robgmsn/PureSequencer/Pure Sequencer.brd

## EAGLE design Pure Sequencer.brd (2021-07-07)

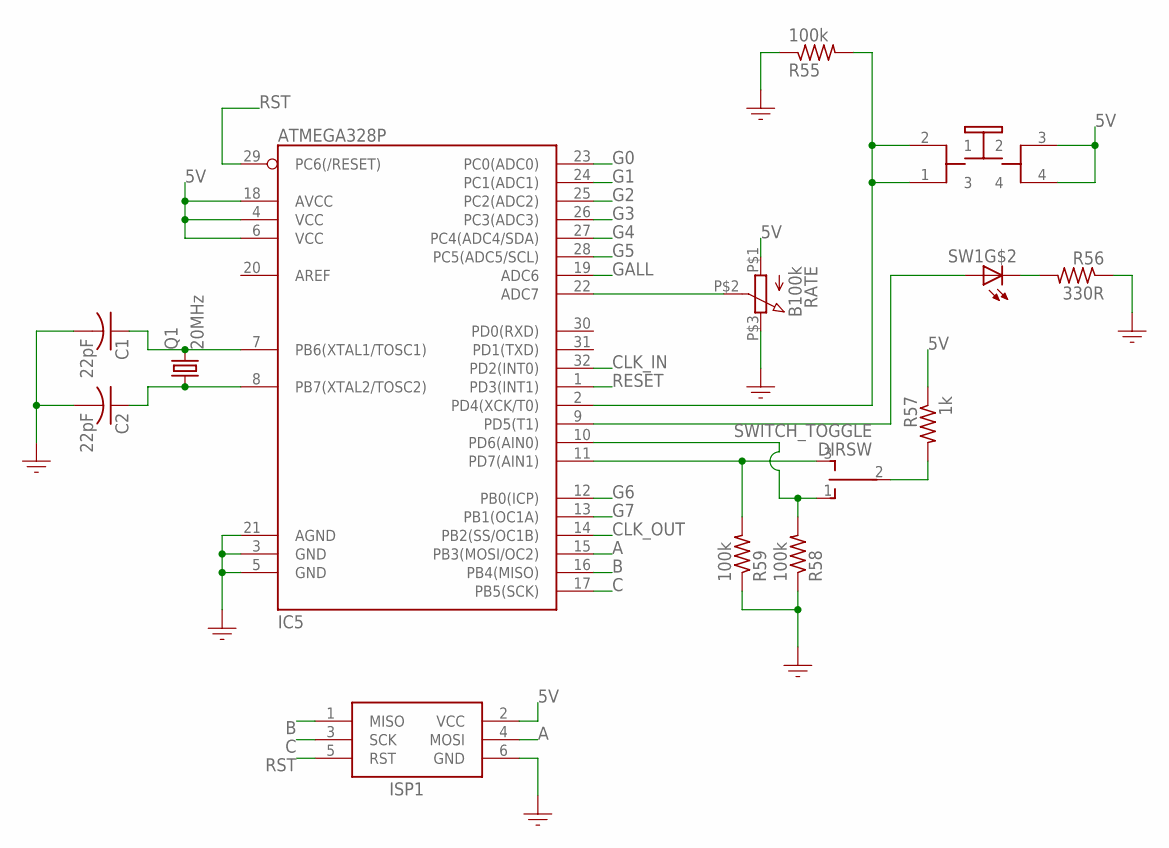
[picture p1: schematic Pure Sequencer.sch, sheet 1]

Parts:
C1, C2: 22pF; C0805
DIRSW: SWITCH_TOGGLE; TOGGLE_SW
IC5: ATMEGA328P; TQFP32-08
ISP1: HEADER2X3-6; AVRISP
Q1: 20MHz; HC49UP
R55, R58, R59: 100k; R0805
R56: 330R; R0805
R57: 1k; R0805
RATE: B100k; POTENTIOMETER_9MM
SW1: SWITCH_PUSHBUTTON_LED; PB6149L

Connections:
5V: IC5.4 (VCC), IC5.6 (VCC), IC5.18 (AVCC), ISP1.2 (VCC), R57.1, RATE.P$1 (1), SW1.3 (2), SW1.4; also elsewhere on the board
A: IC5.15 (PB3(MOSI/OC2)), ISP1.4 (MOSI); also elsewhere on the board
B: IC5.16 (PB4(MISO)), ISP1.1 (MISO); also elsewhere on the board
C: IC5.17 (PB5(SCK)), ISP1.3 (SCK); also elsewhere on the board
CLK_IN: IC5.32 (PD2(INT0)); also elsewhere on the board
CLK_OUT: IC5.14 (PB2(SS/OC1B)); also elsewhere on the board
G0: IC5.23 (PC0(ADC0)); also elsewhere on the board
G1: IC5.24 (PC1(ADC1)); also elsewhere on the board
G2: IC5.25 (PC2(ADC2)); also elsewhere on the board
G3: IC5.26 (PC3(ADC3)); also elsewhere on the board
G4: IC5.27 (PC4(ADC4/SDA)); also elsewhere on the board
G5: IC5.28 (PC5(ADC5/SCL)); also elsewhere on the board
G6: IC5.12 (PB0(ICP)); also elsewhere on the board
G7: IC5.13 (PB1(OC1A)); also elsewhere on the board
GALL: IC5.19 (ADC6)
GND: C1.2, C2.2, IC5.3 (GND), IC5.5 (GND), IC5.21 (AGND), ISP1.6 (GND), R55.1, R56.1, R58.1, R59.1, RATE.P$3 (3); also elsewhere on the board
unnamed: C1.1, IC5.7 (PB6(XTAL1/TOSC1)), Q1.2
unnamed: C2.1, IC5.8 (PB7(XTAL2/TOSC2)), Q1.1
unnamed: IC5.22 (ADC7), RATE.P$2 (2)
unnamed: IC5.2 (PD4(XCK/T0)), R55.2, SW1.1 (3), SW1.2 (1)
unnamed: IC5.9 (PD5(T1)), SW1.A
unnamed: R56.2, SW1.K (C)
unnamed: DIRSW.2, R57.2
unnamed: DIRSW.1 (O), IC5.10 (PD6(AIN0)), R58.2
unnamed: DIRSW.3 (S), IC5.11 (PD7(AIN1)), R59.2
RESET: IC5.1 (PD3(INT1)); also elsewhere on the board
RST: IC5.29 (PC6(/RESET)), ISP1.5 (RST)

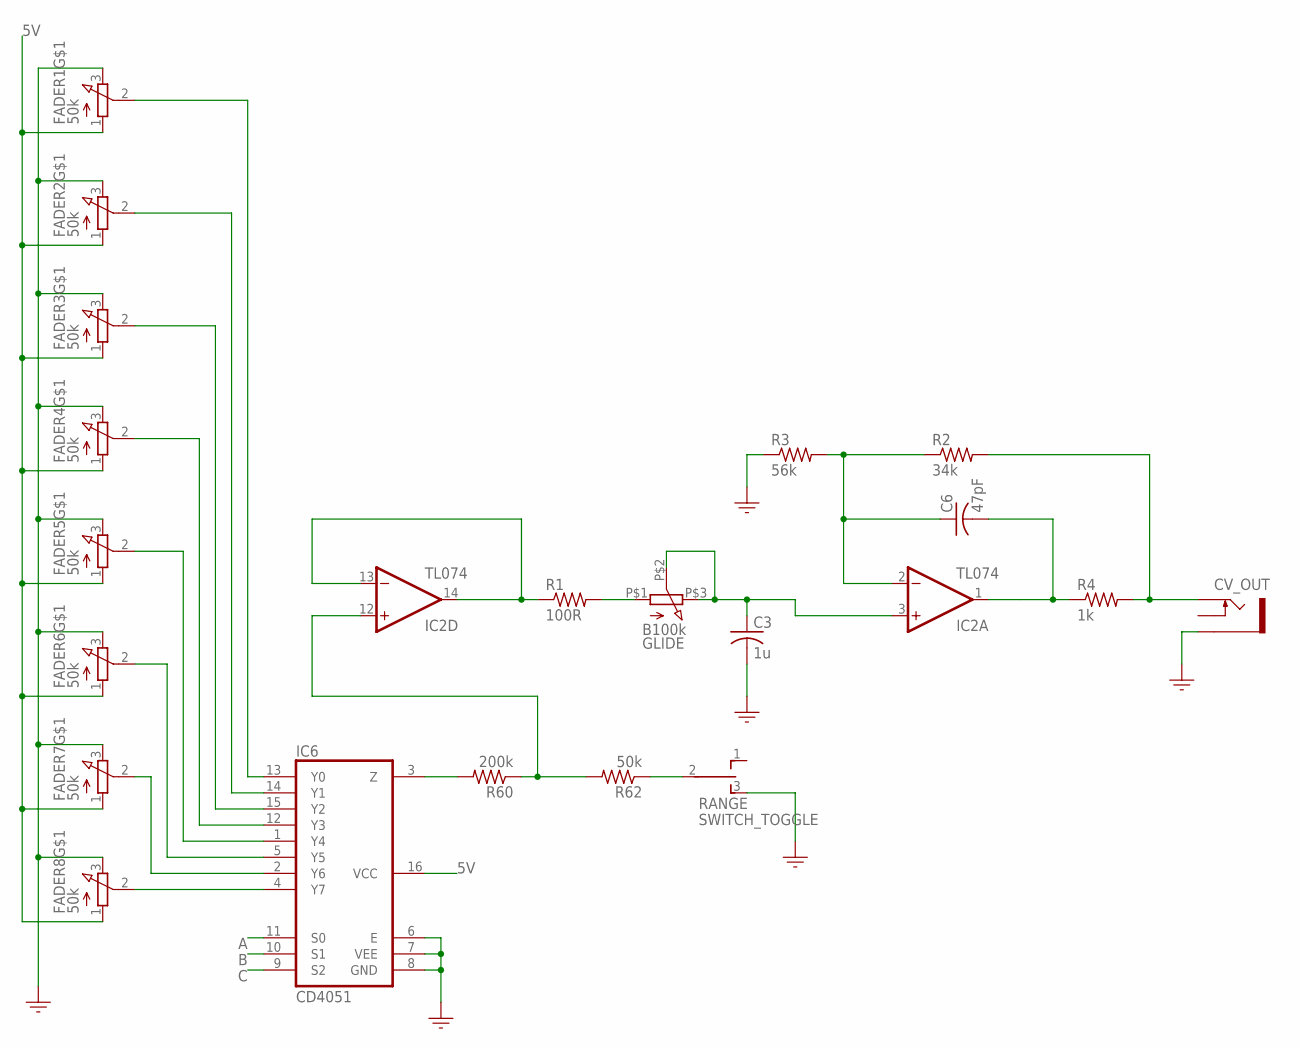
[picture p2: schematic Pure Sequencer.sch, sheet 2]

Parts:
C3: 1u; C0805
C6: 47pF; C0805
CV_OUT: PJ301M-12
FADER1, FADER2, FADER3, FADER4, FADER5, FADER6, FADER7, FADER8: 50k; FADER_20MM_LED
GLIDE: B100k; POTENTIOMETER_9MM
IC2: TL074; SO14
IC6: CD4051; SOIC_16
R1: 100R; R0805
R2: 34k; R0805
R3: 56k; R0805
R4: 1k; R0805
R60: 200k; R0805
R62: 50k; R0805
RANGE: SWITCH_TOGGLE; TOGGLE_SW

Connections:
5V: FADER1.1, FADER2.1, FADER3.1, FADER4.1, FADER5.1, FADER6.1, FADER7.1, FADER8.1, IC6.16 (VCC); also elsewhere on the board
A: IC6.11 (S0); also elsewhere on the board
B: IC6.10 (S1); also elsewhere on the board
C: IC6.9 (S2); also elsewhere on the board
GND: C3.2, CV_OUT.GND (SLEEVE), FADER1.3, FADER2.3, FADER3.3, FADER4.3, FADER5.3, FADER6.3, FADER7.3, FADER8.3, IC6.6 (E), IC6.7 (VEE), IC6.8 (GND), R3.1, RANGE.3 (S); also elsewhere on the board
unnamed: IC2.12 (+IN), R60.1, R62.2
unnamed: IC2.13 (-IN), IC2.14 (OUT), R1.1
unnamed: GLIDE.P$1 (1), R1.2
unnamed: FADER8.2, IC6.4 (Y7)
unnamed: FADER7.2, IC6.2 (Y6)
unnamed: FADER6.2, IC6.5 (Y5)
unnamed: FADER5.2, IC6.1 (Y4)
unnamed: FADER4.2, IC6.12 (Y3)
unnamed: FADER3.2, IC6.15 (Y2)
unnamed: FADER2.2, IC6.14 (Y1)
unnamed: FADER1.2, IC6.13 (Y0)
unnamed: C3.1, GLIDE.P$2 (2), GLIDE.P$3 (3), IC2.3 (+IN)
unnamed: C6.1, IC2.2 (-IN), R2.1, R3.2
unnamed: C6.2, IC2.1 (OUT), R4.1
unnamed: CV_OUT.TIP, R2.2, R4.2
unnamed: IC6.3 (Z), R60.2
unnamed: R62.1, RANGE.2

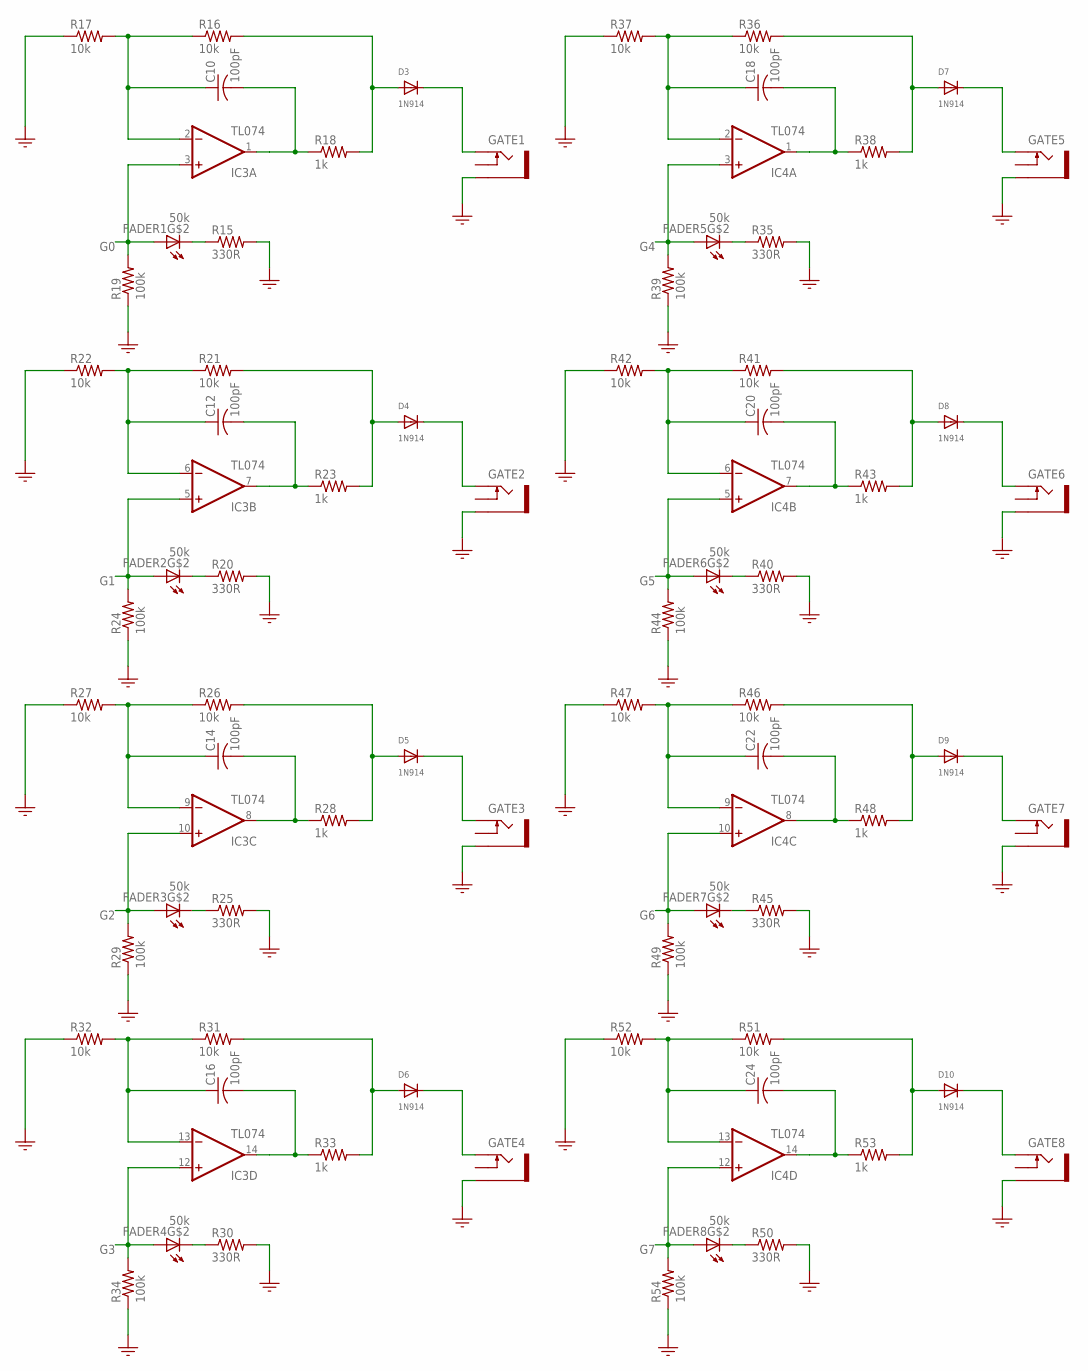
[picture p3: schematic Pure Sequencer.sch, sheet 3]

Parts:
C10, C12, C14, C16, C18, C20, C22, C24: 100pF; C0805
D3, D4, D5, D6, D7, D8, D9, D10: 1N914; DO-41
FADER1, FADER2, FADER3, FADER4, FADER5, FADER6, FADER7, FADER8: 50k; FADER_20MM_LED
GATE1, GATE2, GATE3, GATE4, GATE5, GATE6, GATE7, GATE8: PJ301M-12
IC3, IC4: TL074; SO14
R15, R20, R25, R30, R35, R40, R45, R50: 330R; R0805
R16, R17, R21, R22, R26, R27, R31, R32, R36, R37, R41, R42, R46, R47, R51, R52: 10k; R0805
R18, R23, R28, R33, R38, R43, R48, R53: 1k; R0805
R19, R24, R29, R34, R39, R44, R49, R54: 100k; R0805

Connections:
G0: FADER1.A, IC3.3 (+IN), R19.2; also elsewhere on the board
G1: FADER2.A, IC3.5 (+IN), R24.2; also elsewhere on the board
G2: FADER3.A, IC3.10 (+IN), R29.2; also elsewhere on the board
G3: FADER4.A, IC3.12 (+IN), R34.2; also elsewhere on the board
G4: FADER5.A, IC4.3 (+IN), R39.2; also elsewhere on the board
G5: FADER6.A, IC4.5 (+IN), R44.2; also elsewhere on the board
G6: FADER7.A, IC4.10 (+IN), R49.2; also elsewhere on the board
G7: FADER8.A, IC4.12 (+IN), R54.2; also elsewhere on the board
GND: GATE1.GND (SLEEVE), GATE2.GND (SLEEVE), GATE3.GND (SLEEVE), GATE4.GND (SLEEVE), GATE5.GND (SLEEVE), GATE6.GND (SLEEVE), GATE7.GND (SLEEVE), GATE8.GND (SLEEVE), R15.2, R17.1, R19.1, R20.2, R22.1, R24.1, R25.2, R27.1, R29.1, R30.2, R32.1, R34.1, R35.2, R37.1, R39.1, R40.2, R42.1, R44.1, R45.2, R47.1, R49.1, R50.2, R52.1, R54.1; also elsewhere on the board
unnamed: FADER1.K (C), R15.1
unnamed: C10.1, IC3.2 (-IN), R16.1, R17.2
unnamed: C10.2, IC3.1 (OUT), R18.1
unnamed: D3.A, R16.2, R18.2
unnamed: FADER3.K (C), R25.1
unnamed: FADER2.K (C), R20.1
unnamed: C12.1, IC3.6 (-IN), R21.1, R22.2
unnamed: C12.2, IC3.7 (OUT), R23.1
unnamed: D4.A, R21.2, R23.2
unnamed: C14.1, IC3.9 (-IN), R26.1, R27.2
unnamed: C14.2, IC3.8 (OUT), R28.1
unnamed: D5.A, R26.2, R28.2
unnamed: FADER4.K (C), R30.1
unnamed: C16.1, IC3.13 (-IN), R31.1, R32.2
unnamed: C16.2, IC3.14 (OUT), R33.1
unnamed: D6.A, R31.2, R33.2
unnamed: FADER5.K (C), R35.1
unnamed: C18.1, IC4.2 (-IN), R36.1, R37.2
unnamed: C18.2, IC4.1 (OUT), R38.1
unnamed: D7.A, R36.2, R38.2
unnamed: FADER6.K (C), R40.1
unnamed: C20.1, IC4.6 (-IN), R41.1, R42.2
unnamed: C20.2, IC4.7 (OUT), R43.1
unnamed: D8.A, R41.2, R43.2
unnamed: FADER7.K (C), R45.1
unnamed: C22.1, IC4.9 (-IN), R46.1, R47.2
unnamed: C22.2, IC4.8 (OUT), R48.1
unnamed: D9.A, R46.2, R48.2
unnamed: FADER8.K (C), R50.1
unnamed: C24.1, IC4.13 (-IN), R51.1, R52.2
unnamed: C24.2, IC4.14 (OUT), R53.1
unnamed: D10.A, R51.2, R53.2
unnamed: D6.C, GATE4.TIP
unnamed: D5.C, GATE3.TIP
unnamed: D4.C, GATE2.TIP
unnamed: D3.C, GATE1.TIP
unnamed: D10.C, GATE8.TIP
unnamed: D9.C, GATE7.TIP
unnamed: D8.C, GATE6.TIP
unnamed: D7.C, GATE5.TIP

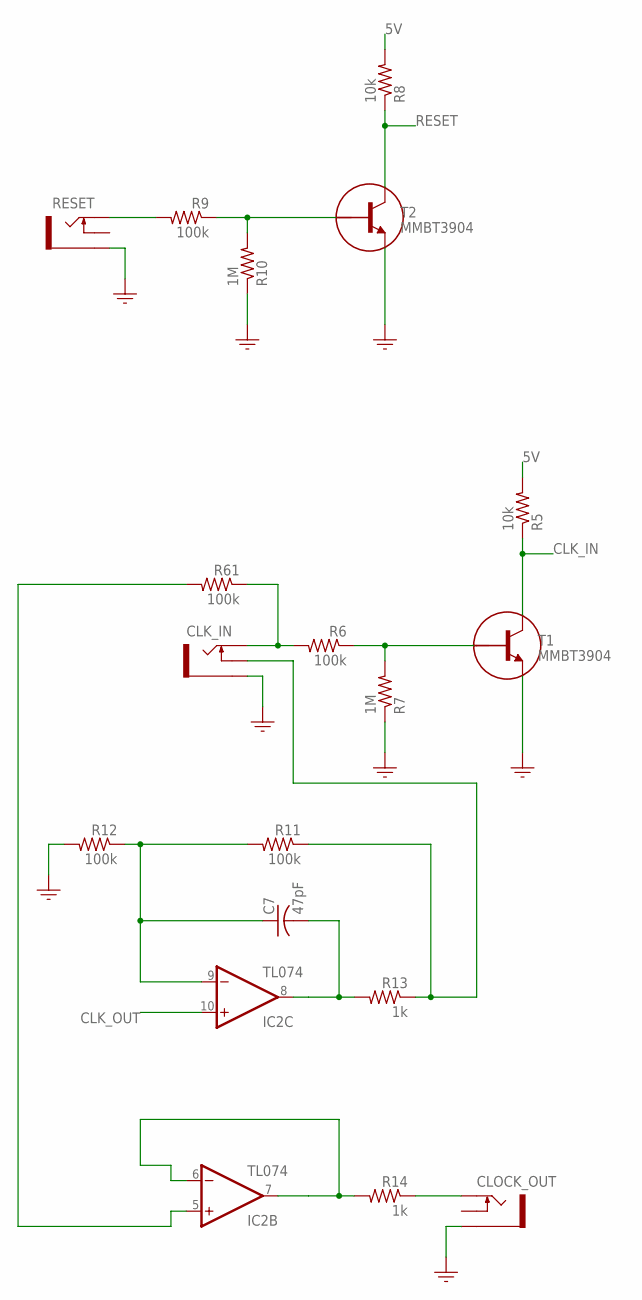
[picture p4: schematic Pure Sequencer.sch, sheet 4]

Parts:
C7: 47pF; C0805
CLK_IN: PJ301M-12
CLOCK_OUT: PJ301M-12
IC2: TL074; SO14
R5, R8: 10k; R0805
R6, R9, R11, R12, R61: 100k; R0805
R7, R10: 1M; R0805
R13, R14: 1k; R0805
RESET: PJ301M-12
T1, T2: MMBT3904; SOT23

Connections:
5V: R5.2, R8.2; also elsewhere on the board
CLK_IN: R5.1, T1.3 (C); also elsewhere on the board
CLK_OUT: IC2.10 (+IN); also elsewhere on the board
GND: CLK_IN.GND (SLEEVE), CLOCK_OUT.GND (SLEEVE), R7.1, R10.1, R12.2, RESET.GND (SLEEVE), T1.2 (E), T2.2 (E); also elsewhere on the board
unnamed: R6.1, R7.2, T1.1 (B)
unnamed: IC2.5 (+IN), R61.2
unnamed: R9.1, R10.2, T2.1 (B)
unnamed: R9.2, RESET.TIP
unnamed: C7.1, IC2.9 (-IN), R11.2, R12.1
unnamed: C7.2, IC2.8 (OUT), R13.2
unnamed: CLK_IN.TIP, R6.2, R61.1
unnamed: IC2.6 (-IN), IC2.7 (OUT), R14.2
unnamed: CLOCK_OUT.TIP, R14.1
unnamed: CLK_IN.NORM (SWITCH), R11.1, R13.1
RESET: R8.1, T2.3 (C); also elsewhere on the board

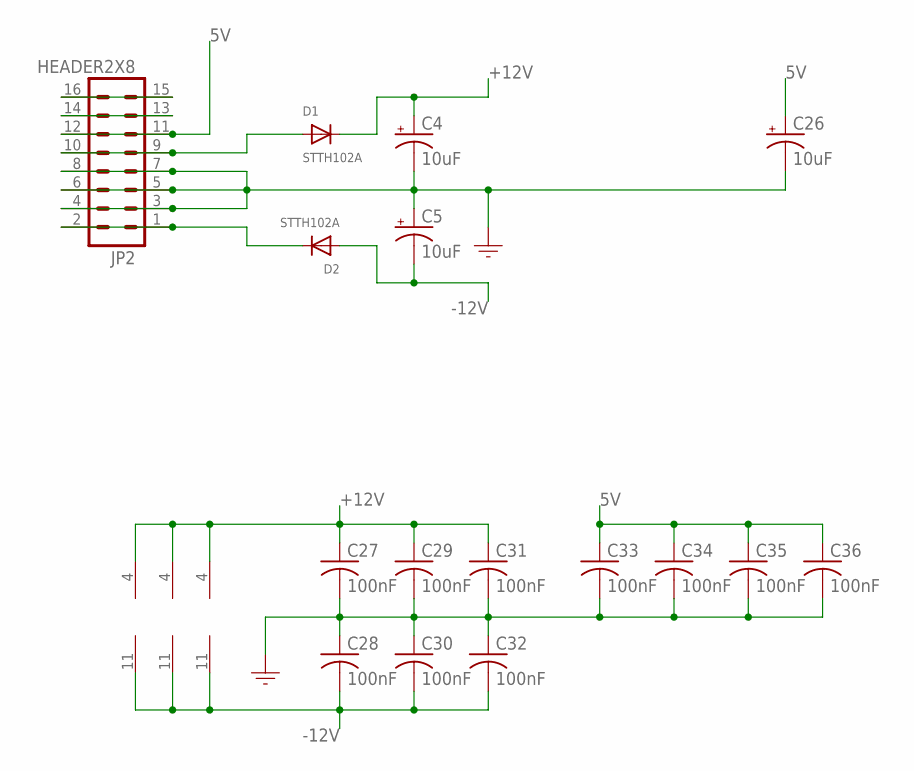
[picture p5: schematic Pure Sequencer.sch, sheet 5]

Parts:
C4, C5, C26: 10uF; 153CLV-0505
C27, C28, C29, C30, C31, C32, C33, C34, C35, C36: 100nF; C0805
D1, D2: STTH102A; SMADIODE
IC2, IC3, IC4: TL074; SO14
JP2: HEADER2X8; POWER_SHROUDED

Connections:
5V: C26.+, C33.1, C34.1, C35.1, C36.1, JP2.11, JP2.12; also elsewhere on the board
+12V: C4.+, C27.1, C29.1, C31.1, D1.C, IC2.4 (V+), IC3.4 (V+), IC4.4 (V+)
-12V: C5.-, C28.2, C30.2, C32.2, D2.A, IC2.11 (V-), IC3.11 (V-), IC4.11 (V-)
GND: C4.-, C5.+, C26.-, C27.2, C28.1, C29.2, C30.1, C31.2, C32.1, C33.2, C34.2, C35.2, C36.2, JP2.3, JP2.4, JP2.5, JP2.6, JP2.7, JP2.8; also elsewhere on the board
unnamed: D1.A, JP2.9, JP2.10
unnamed: D2.C, JP2.1, JP2.2
unnamed: JP2.13, JP2.14
unnamed: JP2.15, JP2.16

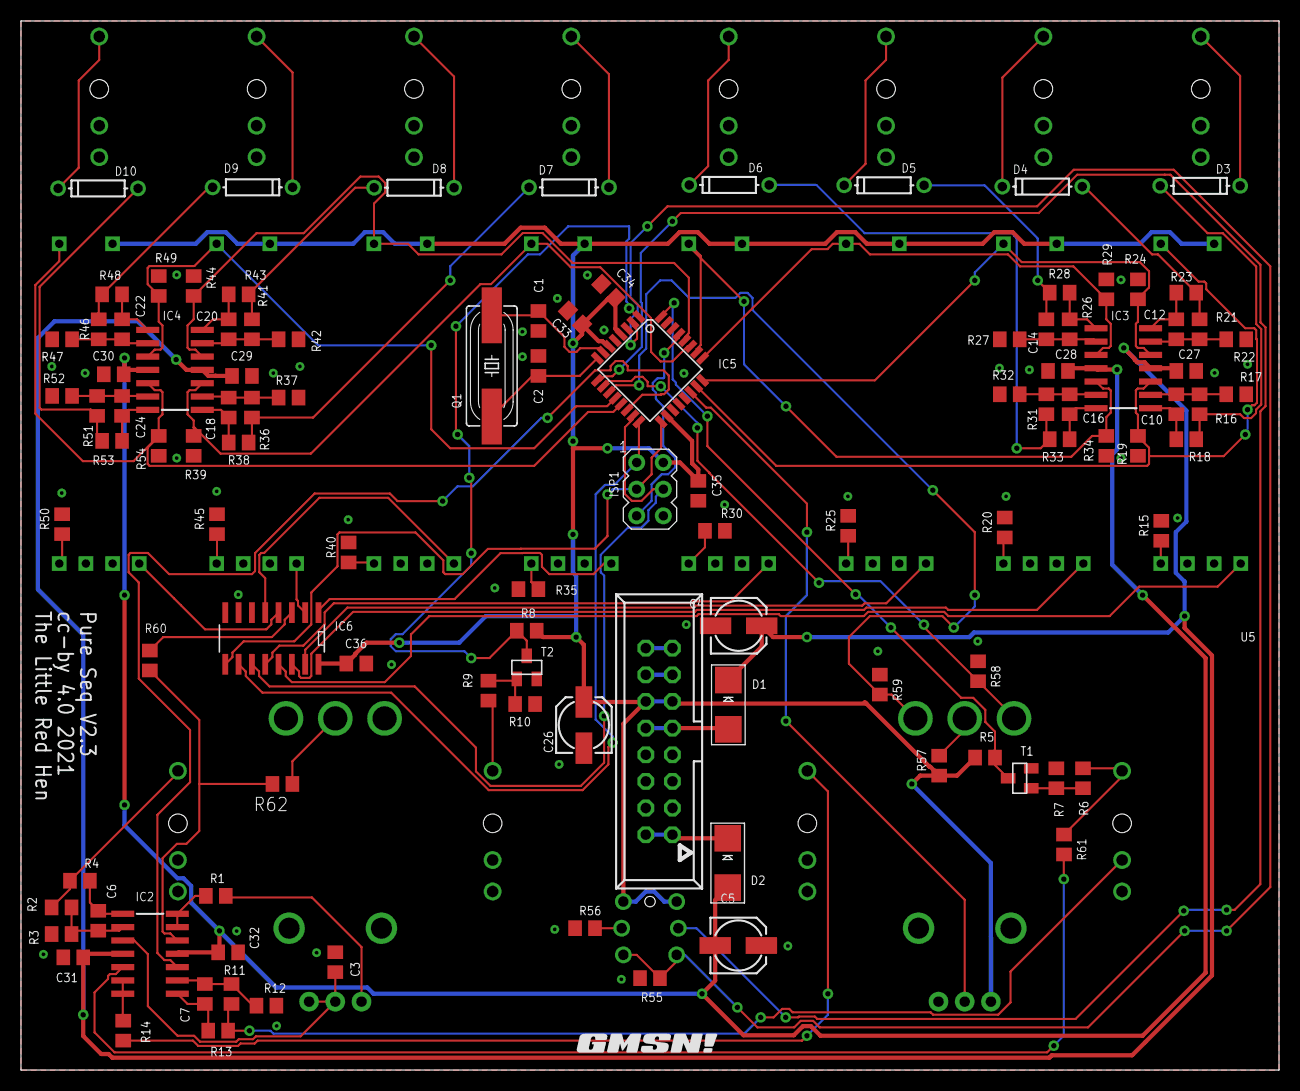
[picture p6: board Pure Sequencer.brd from above]

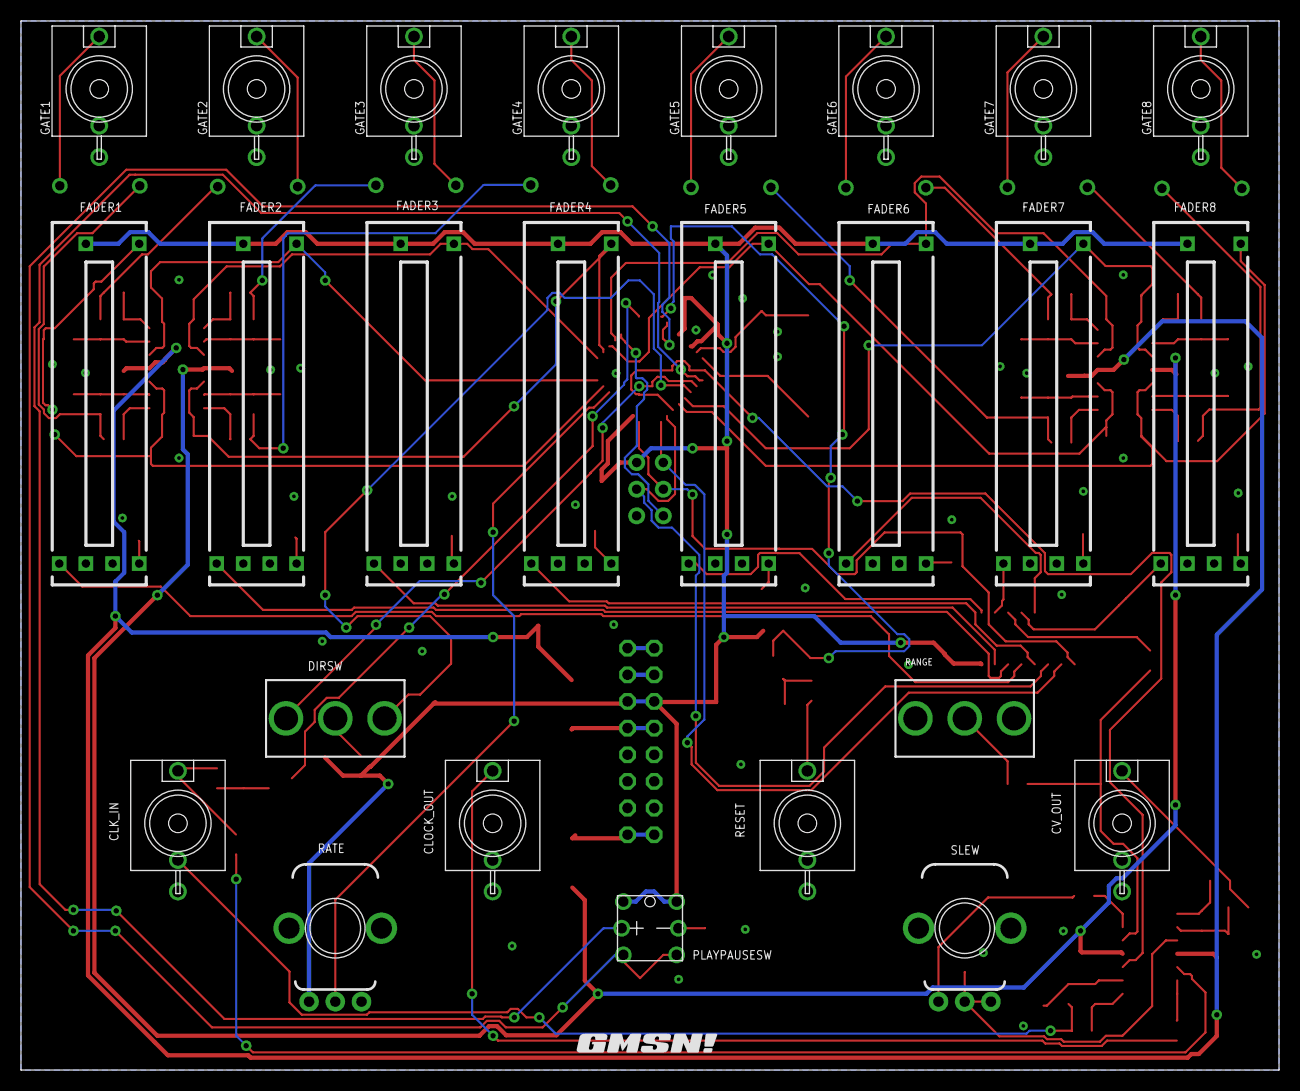
[picture p7: board Pure Sequencer.brd from below]

Board: 2 copper layers, 119.9 x 100.0 mm, 135 parts (26 on the bottom side), 99 nets.

Other parts of the board:
U$1, U$2: GMSN!_LOGO
