robgmsn/PureSequencer/(commit log)

2021-04-16 Sequencer 2.1
    [Pure Sequencer.brd, Pure Sequencer.sch]
2021-04-16 Sequencer 2.2
    [Pure Sequencer.brd, Pure Sequencer.sch]
2021-04-20 Sequencer 2.3
    Sequencer Updated to V2.3 20/4/21
    Power Supply updated pull 5V from main case power supply, in line with low noise techniques.
    Some resistor values reduced to 10k, in line with low noise techniques.
    Traces rerouted.
    [Pure Sequencer.brd, Pure Sequencer.csv, Pure Sequencer.sch]
2021-04-25 Sequencer 2.21
    Code moved to folder as per Arduino IDE requirements.
2021-04-28 Sequencer 2.31
    Sequencer Updated to V2.31 28/4/21
    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
