robgmsn/PureSequencer/(notices)

Notices in the files:
Pure Sequencer.brd:
cc-by 4.0 2021
